nathanJarvis/audio_equalizer/PmodLTC1654.pdf

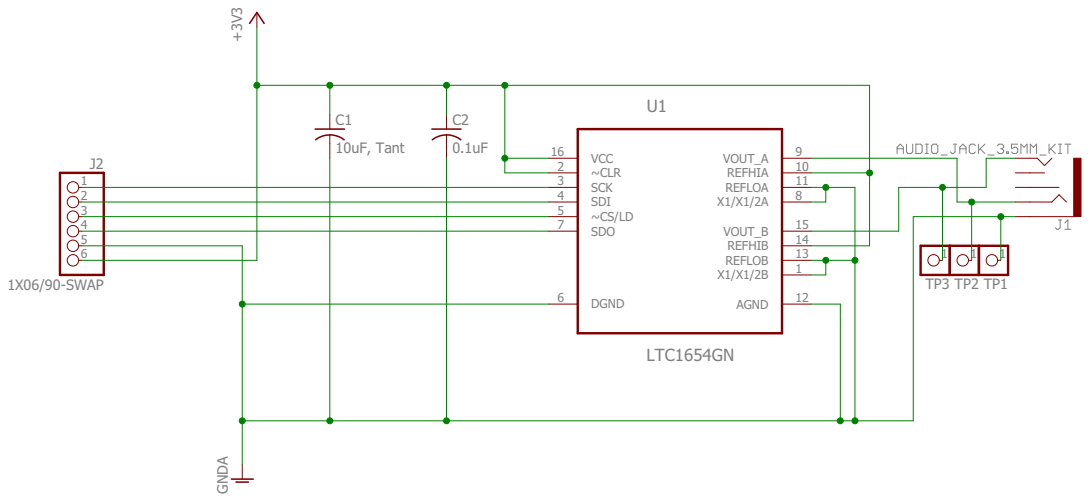
[picture p19: page 1]

+3V3 GNDA LTC1654GN 10uF, Tant 0.1uF 1X06/90-SWAP VCC 16 ~CLR 2 SCK 3 ~CS/LD 5 SDI 4 X1/X1/2B 1 AGND 12 SDO 7 VOUT_A 9 VOUT_B 15 REFHIB 14 REFLOB 13 U1 X1/X1/2A 8 DGND 6 REFHIA 10 REFLOA 11 C1 C2 J2 123456 1 TP1 1 TP3 1 TP2
