nathanJarvis/audio_equalizer/PmodLTC1865L.pdf

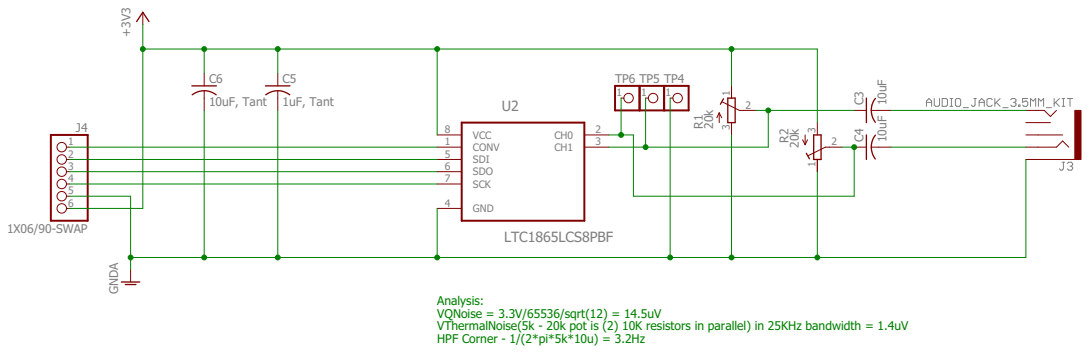
[picture p20: page 1]
